Aryan-G4/hornet_kb/README.md

# hornet_kb
Hardware and Firmware for the Hornet Keyboard: a wireless. split. lowprofile hotswap keybaord
