Aryan-G4/hornet_kb/Hardware/hornet_kb.kicad_pcb

## KiCad design Hardware/hornet_kb.kicad_pcb (2025-10-25)

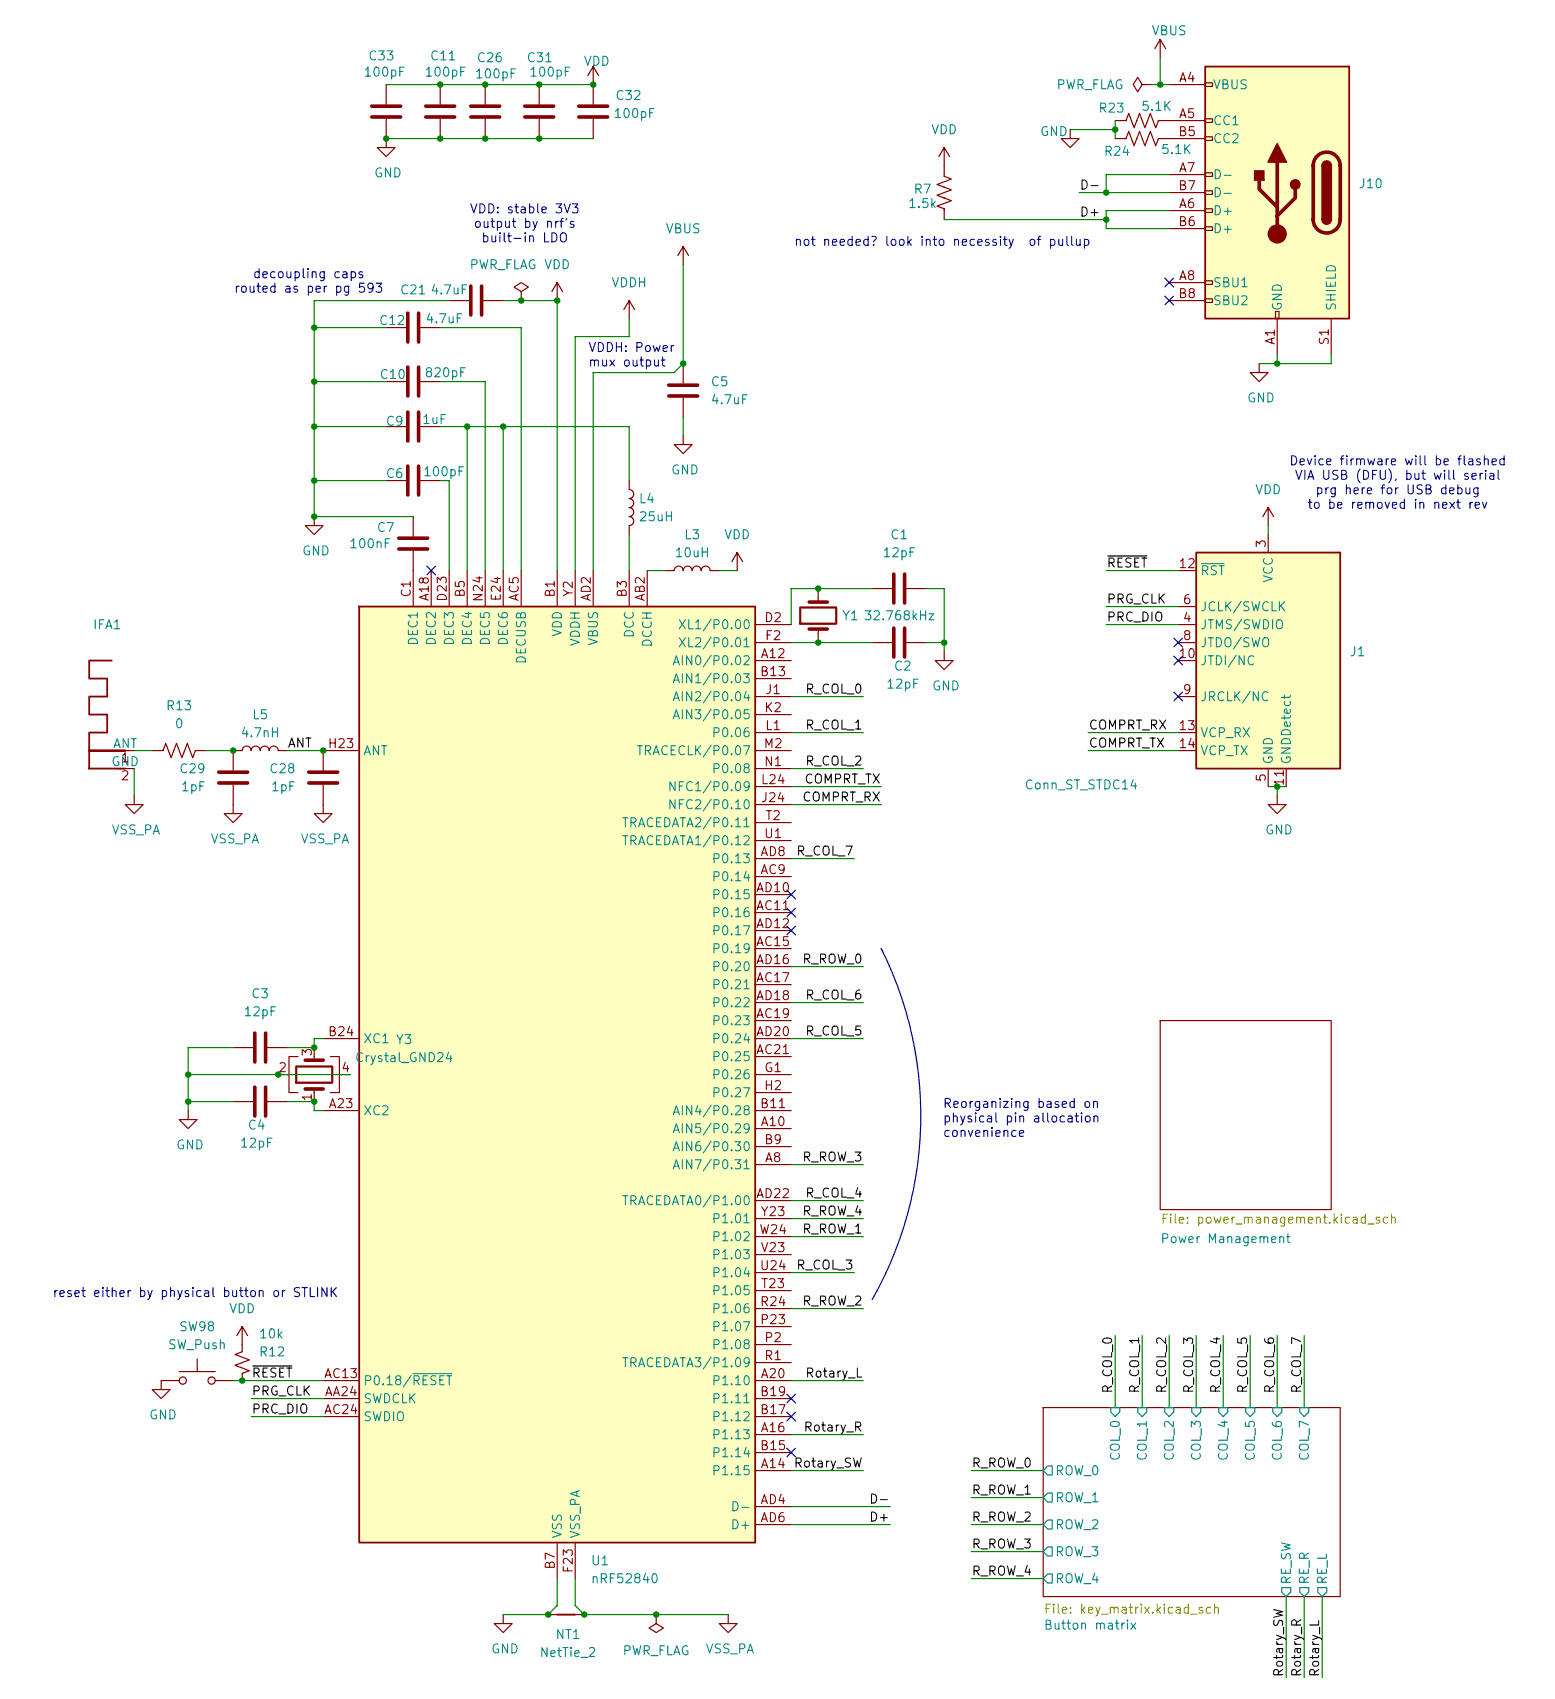
[picture p1: schematic hornet_kb.kicad_sch, Hornet Wireless Split Keyboard]

Parts:
C1, C2, C3, C4: 12pF; C_0402_1005Metric
C5, C12, C21: 4.7uF; C_0805_2012Metric
C6, C11, C26, C31, C32, C33: 100pF; C_0603_1608Metric
C7: 100nF; C_0603_1608Metric
C9: 1uF; C_0603_1608Metric
C10: 820pF; C_0603_1608Metric
C28, C29: 1pF; C_0402_1005Metric
IFA1: Texas_SWRA117D_2.4GHz_Right
J1: Conn_ST_STDC14; Tag-Connect_TC2070-IDC-FP_2x07_P1.27mm_Vertical
J10: USB_C_Receptacle_USB2.0; USB_C_Receptacle_HRO_TYPE-C-31-M-12; LCSC C165948
L3: 10uH; L_0402_1005Metric
L4: 25uH; L_0402_1005Metric
L5: 4.7nH; L_0402_1005Metric
NT1: NetTie_2; NetTie-2_SMD_Pad2.0mm
R7: 1.5k; R_0603_1608Metric; LCSC C23345
R12: 10k; R_0603_1608Metric
R13: 0; R_0402_1005Metric
R23, R24: 5.1K; R_0603_1608Metric; LCSC C23186
SW98: SW_Push; SW_Push_1P1T-MP_NO_Horizontal_Alps_SKRTLAE010
U1: nRF52840; Nordic_AQFN-73-1EP_7x7mm_P0.5mm
Y1: 32.768kHz; Crystal_SMD_3215-2Pin_3.2x1.5mm
Y3: Crystal_GND24; Crystal_SMD_2016-4Pin_2.0x1.6mm

Connections:
/ANT: C28.1, L5.1, U1.H23 (ANT)
/COMPRT_RX: J1.13 (VCP_RX), U1.J24 (NFC2/P0.10)
/COMPRT_TX: J1.14 (VCP_TX), U1.L24 (NFC1/P0.09)
/D+: J10.A6 (D+), J10.B6 (D+), R7.2, U1.AD6 (D+)
/D-: J10.A7 (D-), J10.B7 (D-), U1.AD4 (D-)
/PRC_DIO: J1.4 (JTMS/SWDIO), U1.AC24 (SWDIO)
/PRG_CLK: J1.6 (JCLK/SWCLK), U1.AA24 (SWDCLK)
/R_COL_0: U1.J1 (AIN2/P0.04); also elsewhere on the board
/R_COL_1: U1.L1 (P0.06); also elsewhere on the board
/R_COL_2: U1.N1 (P0.08); also elsewhere on the board
/R_COL_3: U1.U24 (P1.04); also elsewhere on the board
/R_COL_4: U1.AD22 (TRACEDATA0/P1.00); also elsewhere on the board
/R_COL_5: U1.AD20 (P0.24); also elsewhere on the board
/R_COL_6: U1.AD18 (P0.22); also elsewhere on the board
/R_COL_7: U1.AD8 (P0.13); also elsewhere on the board
/R_ROW_0: U1.AD16 (P0.20); also elsewhere on the board
/R_ROW_1: U1.W24 (P1.02); also elsewhere on the board
/R_ROW_2: U1.R24 (P1.06); also elsewhere on the board
/R_ROW_3: U1.A8 (AIN7/P0.31); also elsewhere on the board
/R_ROW_4: U1.Y23 (P1.01); also elsewhere on the board
/Rotary_L: U1.A20 (P1.10); also elsewhere on the board
/Rotary_R: U1.A16 (P1.13); also elsewhere on the board
/Rotary_SW: U1.A14 (P1.15); also elsewhere on the board
/~RESET: J1.12 (~RST), R12.2, SW98.1, U1.AC13 (P0.18/~RESET)
GND: C1.1, C2.1, C3.1, C4.1, C5.2, C6.2, C7.2, C9.2, C10.1, C11.2, C12.2, C21.1, C26.2, C31.2, C32.2, C33.2, J1.5 (GND), J1.7 (GND), J1.11 (GNDDetect), J10.A1 (GND), J10.A12 (GND), J10.B1 (GND), J10.B12 (GND), J10.S1 (SHIELD), NT1.2, R23.1, R24.1, SW98.2, U1.B7 (VSS), U1.EP (VSS), Y3.2, Y3.4; also elsewhere on the board
unnamed: C29.1, L5.2, R13.2
unnamed: IFA1.1 (ANT), R13.1
unnamed: J10.A5 (CC1), R23.2
unnamed: J10.B5 (CC2), R24.2
unnamed: L4.1, U1.B3 (DCC)
unnamed: L3.2, U1.AB2 (DCCH)
unnamed: C7.1, U1.C1 (DEC1)
unnamed: C6.1, U1.D23 (DEC3)
unnamed: C9.1, L4.2, U1.B5 (DEC4), U1.E24 (DEC6)
unnamed: C10.2, U1.N24 (DEC5)
unnamed: C12.1, U1.AC5 (DECUSB)
unnamed: C3.2, U1.B24 (XC1), Y3.3
unnamed: C4.2, U1.A23 (XC2), Y3.1
unnamed: C1.2, U1.D2 (XL1/P0.00), Y1.2
unnamed: C2.2, U1.F2 (XL2/P0.01), Y1.1
VBUS: C5.1, J10.A4 (VBUS), J10.A9 (VBUS), J10.B4 (VBUS), J10.B9 (VBUS), U1.AD2 (VBUS); also elsewhere on the board
VDD: C11.1, C21.2, C26.1, C31.1, C32.1, C33.1, J1.3 (VCC), L3.1, R7.1, R12.1, U1.A22 (VDD), U1.AD14 (VDD), U1.AD23 (VDD), U1.B1 (VDD), U1.W1 (VDD); also elsewhere on the board
VDDH: U1.Y2 (VDDH); also elsewhere on the board
VSS_PA: C28.2, C29.2, IFA1.2 (GND), NT1.1, U1.F23 (VSS_PA)

Notes on the sheet:
Reorganizing based on physical pin allocation convenience
VDDH: Power mux output
Device firmware will be flashed VIA USB (DFU), but will serial prg here for USB debug to be removed in next rev
decoupling caps routed as per pg 593
VDD: stable 3V3 output by nrf's built-in LDO
reset either by physical button or STLINK
not needed? look into necessity of pullup

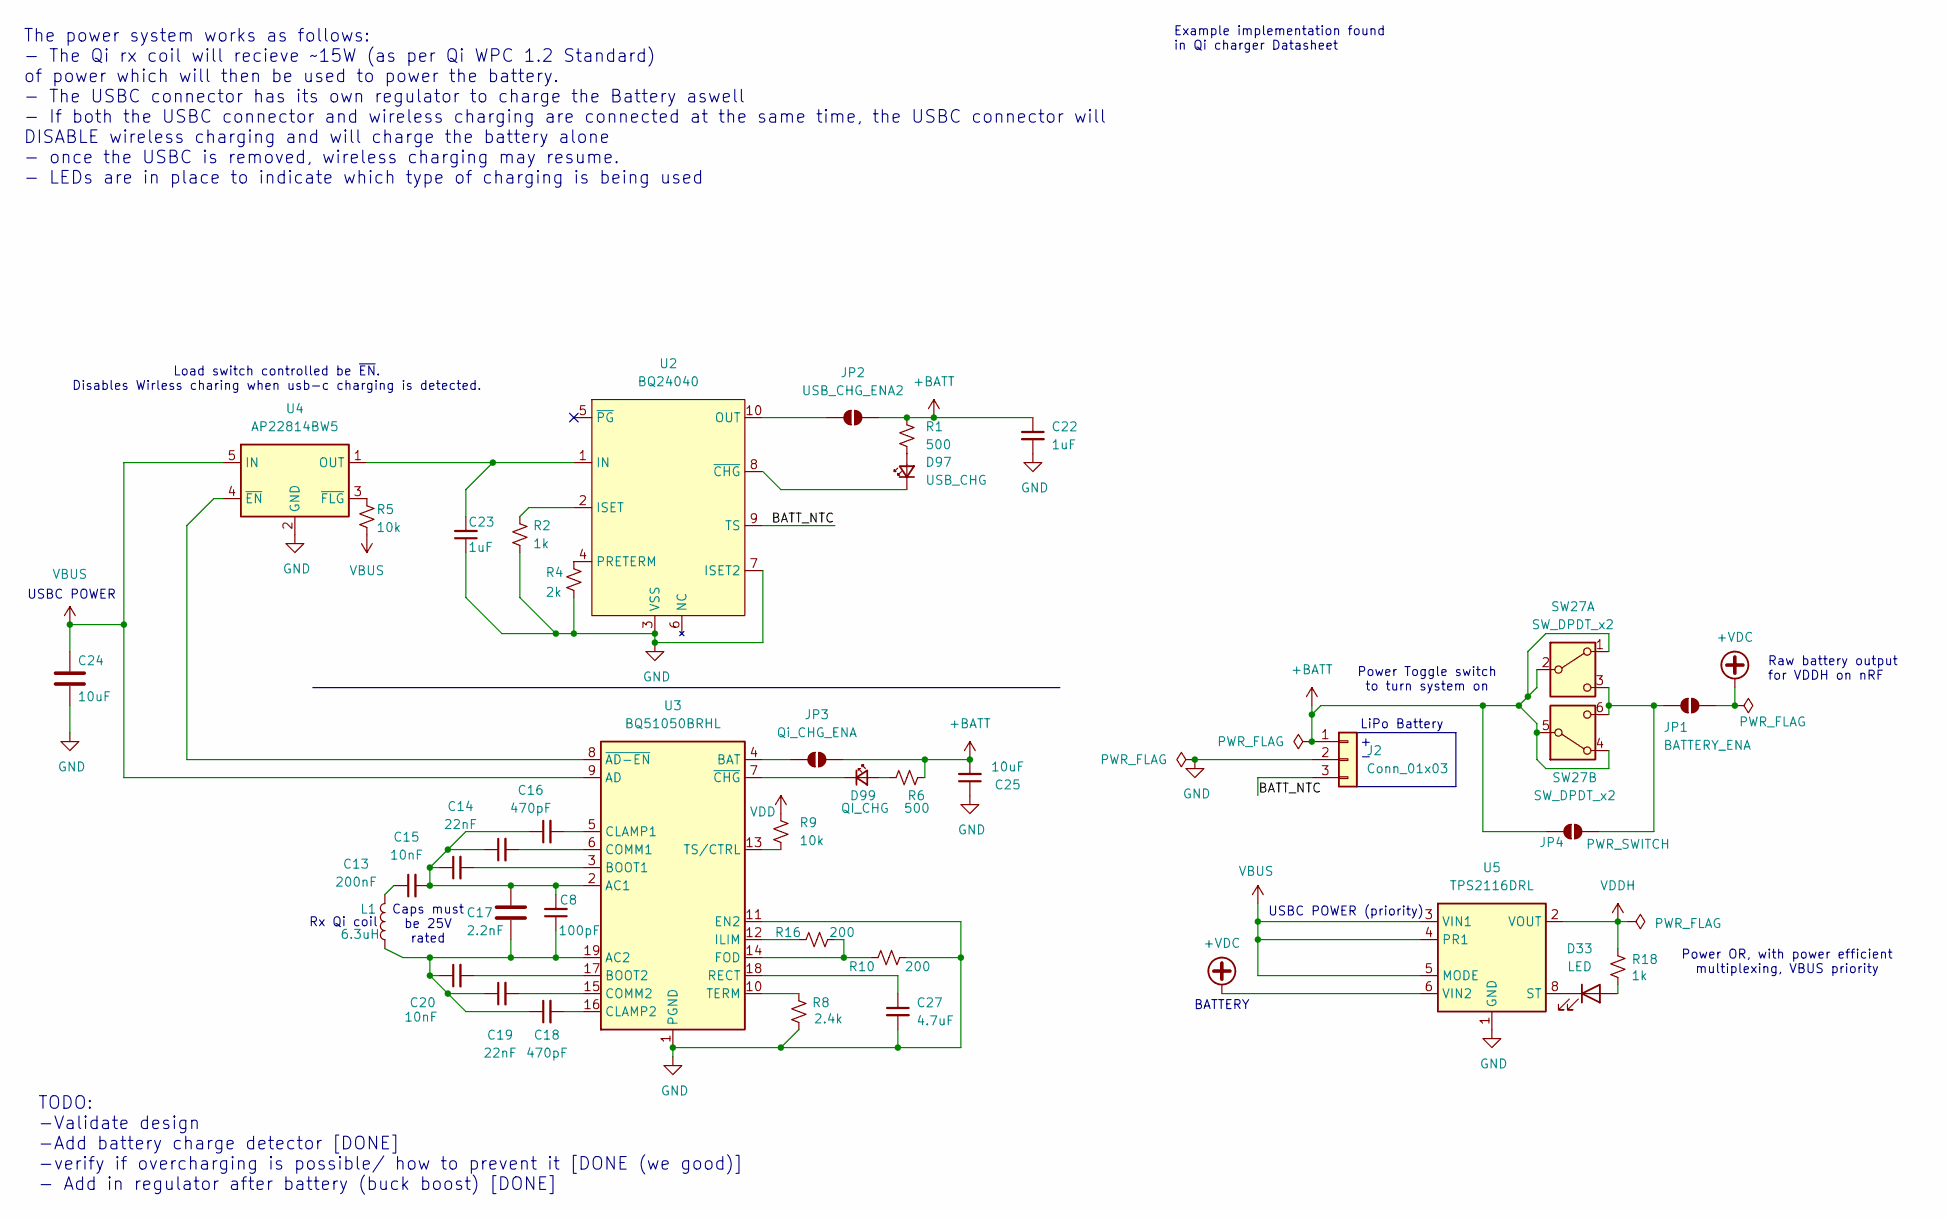
[picture p2: schematic power_management.kicad_sch, Hornet Wireless Split Keyboard]

Parts:
C8: 100pF; C_0603_1608Metric
C13: 200nF; C_0603_1608Metric
C14, C19: 22nF; C_0603_1608Metric
C15, C20: 10nF; C_0603_1608Metric
C16, C18: 470pF; C_0603_1608Metric
C17: 2.2nF; C_0603_1608Metric
C22, C23: 1uF; C_0603_1608Metric
C24, C25: 10uF; C_0603_1608Metric
C27: 4.7uF; C_0603_1608Metric
D33: LED; LED_0402_1005Metric
D97: USB_CHG; LED_0402_1005Metric
D99: QI_CHG; LED_0402_1005Metric
J2: Conn_01x03; JST_GH_SM03B-GHS-TB_1x03-1MP_P1.25mm_Horizontal
JP1: BATTERY_ENA; SolderJumper-2_P1.3mm_Open_TrianglePad1.0x1.5mm
JP2: USB_CHG_ENA2; SolderJumper-2_P1.3mm_Open_TrianglePad1.0x1.5mm
JP3: Qi_CHG_ENA; SolderJumper-2_P1.3mm_Open_TrianglePad1.0x1.5mm
JP4: PWR_SWITCH; SolderJumper-2_P1.3mm_Open_TrianglePad1.0x1.5mm
L1: 6.3uH; JST_EH_S2B-EH_1x02_P2.50mm_Horizontal
R1, R6: 500; R_0603_1608Metric
R2, R18: 1k; R_0603_1608Metric
R4: 2k; R_0603_1608Metric
R5, R9: 10k; R_0603_1608Metric
R8: 2.4k; R_0603_1608Metric
R10, R16: 200; R_0603_1608Metric
SW27: SW_DPDT_x2; SW_CK_JS202011CQN_DPDT_Straight
U2: BQ24040; Texas_DLH0010A_WSON-10-1EP_2.2x2mm_P0.4mm_EP0.9x1.5mm_Therm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
U3: BQ51050BRHL; Texas_VQFN-RHL-20
U4: AP22814BW5; SOT-23-5
U5: TPS2116DRL; SOT-583-8

Connections:
+BATT: C22.1, C25.2, J2.1, JP2.2 (B), JP3.2 (B), JP4.1 (A), R1.1, R6.1, SW27.1 (A), SW27.2 (B), SW27.4 (A), SW27.5 (B)
+VDC: JP1.2 (B), U5.6 (VIN2)
/Power Management/BATT_NTC: J2.3, U2.9 (TS)
GND: C22.2, C23.1, C24.2, C25.1, C27.2, J2.2, R2.1, R4.1, R8.2, R10.2, U2.3 (VSS), U2.7 (ISET2), U3.1 (PGND), U3.11 (EN2), U3.20 (PGND), U3.21 (PGND), U4.2 (GND), U5.1 (GND); also elsewhere on the board
unnamed: C13.1, L1.2
unnamed: D33.2 (A), R18.1
unnamed: D33.1 (K), U5.8 (ST)
unnamed: D97.2 (A), R1.2
unnamed: D97.1 (K), U2.8 (~CHG)
unnamed: D99.2 (A), R6.2
unnamed: D99.1 (K), U3.7 (~CHG)
unnamed: JP1.1 (A), JP4.2 (B), SW27.3 (C), SW27.6 (C)
unnamed: JP2.1 (A), U2.10 (OUT)
unnamed: JP3.1 (A), U3.4 (BAT)
unnamed: C23.2, U2.1 (IN), U4.1 (OUT)
unnamed: R2.2, U2.2 (ISET)
unnamed: R4.2, U2.4 (PRETERM)
unnamed: C8.2, C13.2, C14.1, C15.1, C16.1, C17.1, U3.2 (AC1)
unnamed: C8.1, C17.2, C18.1, C19.1, C20.1, L1.1, U3.19 (AC2)
unnamed: C15.2, U3.3 (BOOT1)
unnamed: C20.2, U3.17 (BOOT2)
unnamed: C16.2, U3.5 (CLAMP1)
unnamed: C18.2, U3.16 (CLAMP2)
unnamed: C14.2, U3.6 (COMM1)
unnamed: C19.2, U3.15 (COMM2)
unnamed: R10.1, R16.2, U3.14 (FOD)
unnamed: R16.1, U3.12 (ILIM)
unnamed: C27.1, U3.18 (RECT)
unnamed: R8.1, U3.10 (TERM)
unnamed: R9.2, U3.13 (TS/CTRL)
unnamed: U3.8 (~AD-EN), U4.4 (~EN)
unnamed: R5.2, U4.3 (~FLG)
VBUS: C24.1, R5.1, U3.9 (AD), U4.5 (IN), U5.3 (VIN1), U5.4 (PR1), U5.5 (MODE); also elsewhere on the board
VDD: R9.1; also elsewhere on the board
VDDH: R18.2, U5.2 (VOUT), U5.7 (VOUT); also elsewhere on the board

Notes on the sheet:
Power OR, with power efficient multiplexing, VBUS priority
Rx Qi coil
The power system works as follows: - The Qi rx coil will recieve ~15W (as per Qi WPC 1.2 Standard) of power which will then be used to power the battery. - The USBC connector has its own regulator to charge the Battery aswell - If both the USBC connector and wireless charging are connected at the s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
Raw battery output for VDDH on nRF
USBC POWER (priority)
USBC POWER
LiPo Battery
Example implementation found in Qi charger Datasheet
BATTERY
Caps must be 25V rated
Load switch controlled be ~{EN}. Disables Wirless charing when usb-c charging is detected.
Power Toggle switch to turn system on
+ -
TODO: -Validate design -Add battery charge detector [DONE] -verify if overcharging is possible/ how to prevent it [DONE (we good)] - Add in regulator after battery (buck boost) [DONE]

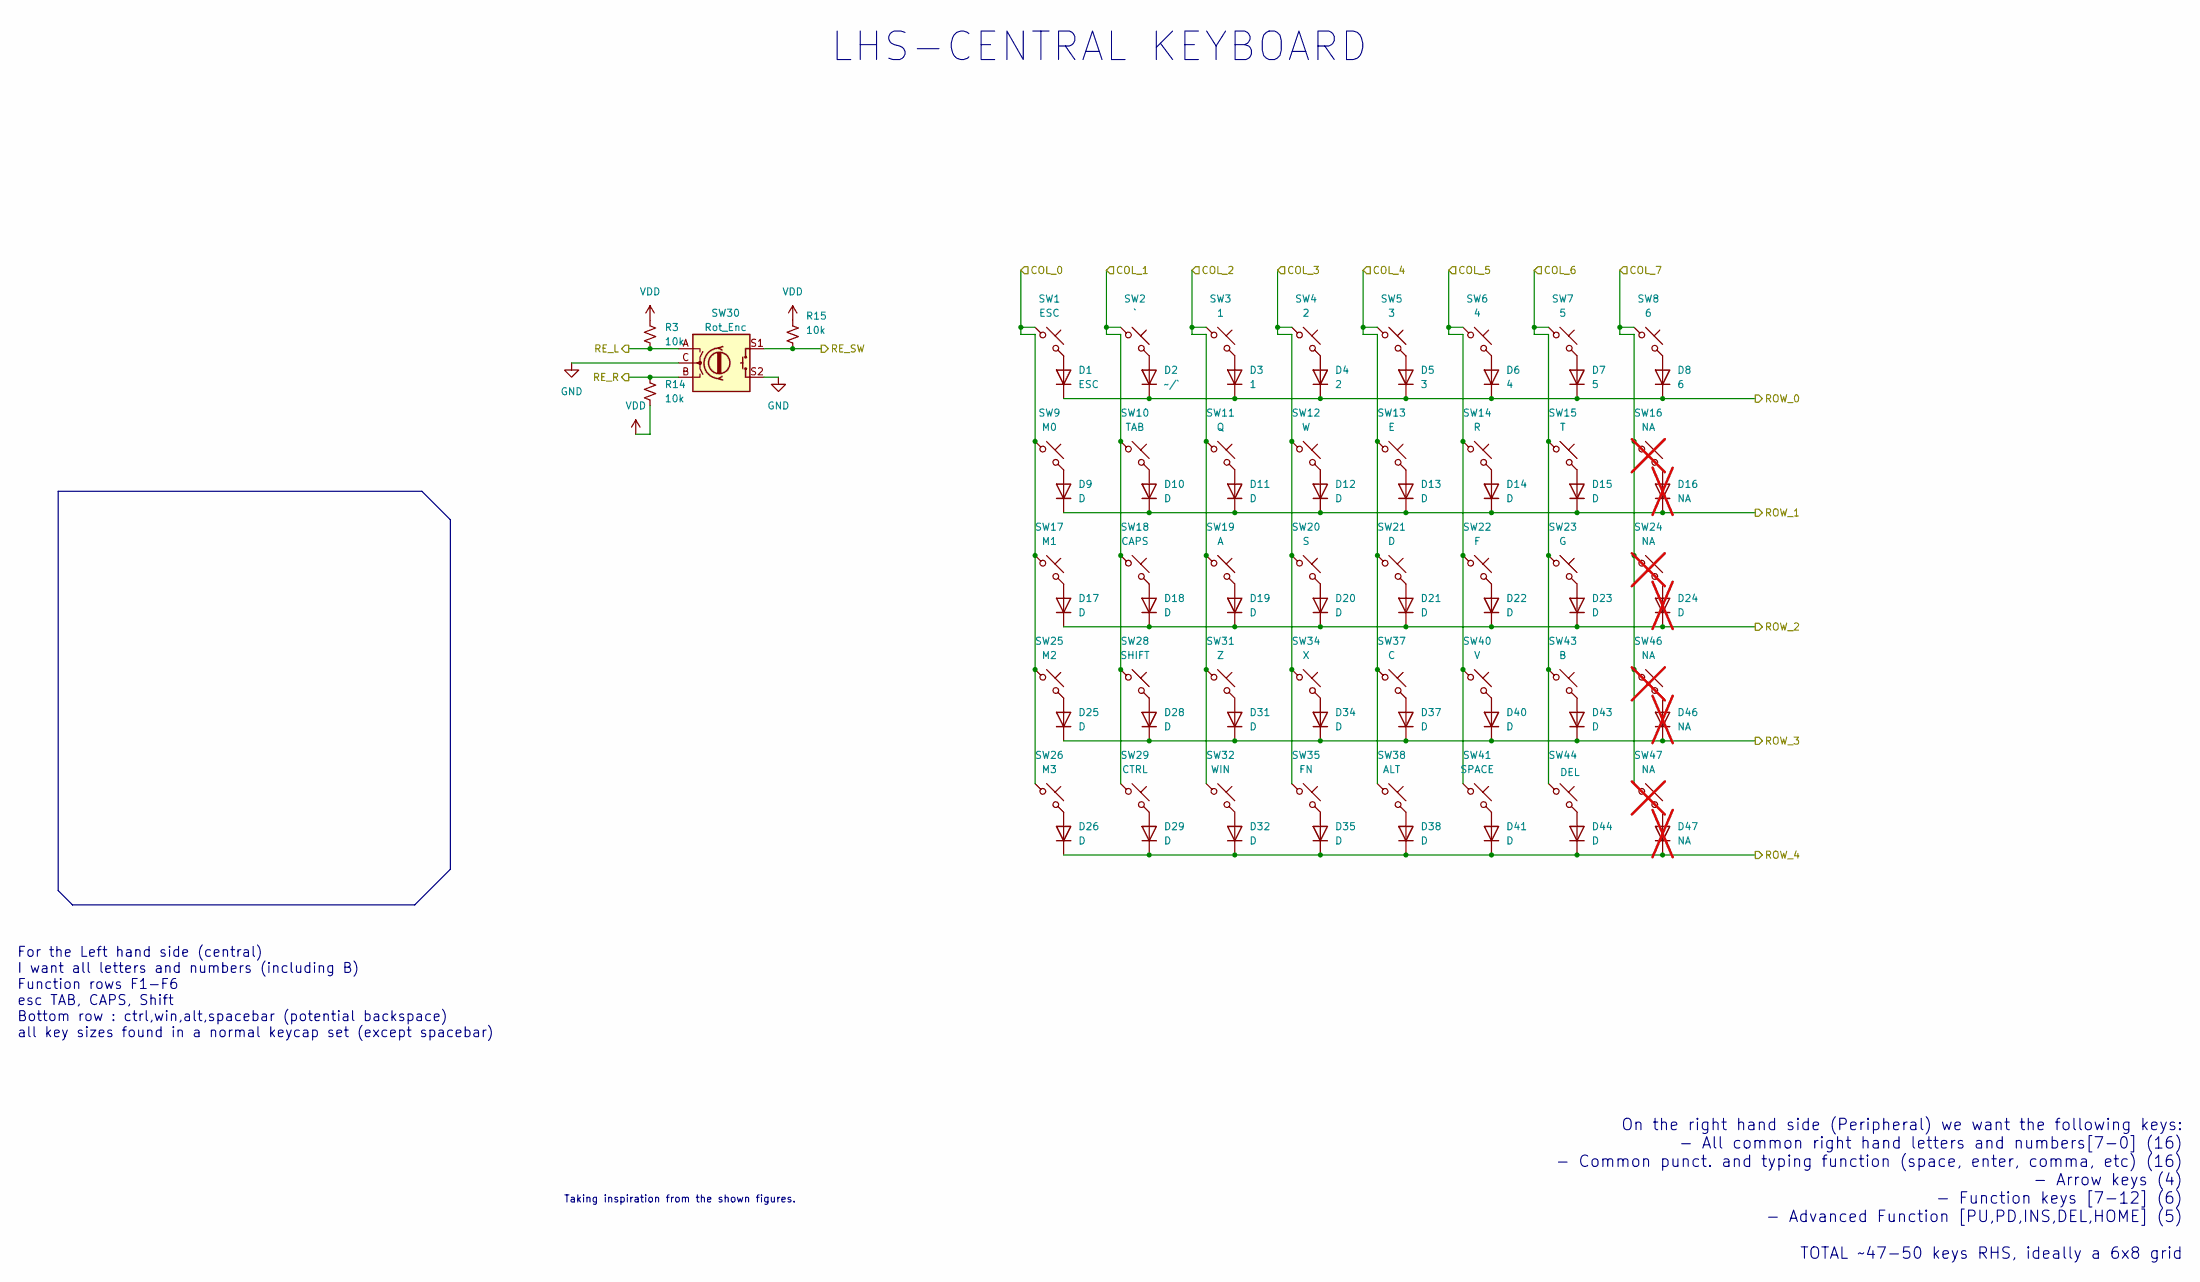
[picture p3: schematic key_matrix.kicad_sch, Hornet Wireless Split Keyboard]

Parts:
D1: ESC; Diode_SOD-123
D2: ~/`; Diode_SOD-123
D3: 1; Diode_SOD-123
D4: 2; Diode_SOD-123
D5: 3; Diode_SOD-123
D6: 4; Diode_SOD-123
D7: 5; Diode_SOD-123
D8: 6; Diode_SOD-123
D9, D10, D11, D12, D13, D14, D15, D17, D18, D19, D20, D21, D22, D23, D25, D26, D28, D29, D31, D32, D34, D35, D37, D38, D40, D41, D43, D44: D; Diode_SOD-123
D16, D46, D47: NA; Diode_SOD-123; not fitted
D24: D; Diode_SOD-123; not fitted
R3, R14, R15: 10k; R_0603_1608Metric
SW1: ESC; Hotswap_MX_1.00u
SW2: `; Hotswap_MX_1.00u
SW3: 1; Hotswap_MX_1.00u
SW4: 2; Hotswap_MX_1.00u
SW5: 3; Hotswap_MX_1.00u
SW6: 4; Hotswap_MX_1.00u
SW7: 5; Hotswap_MX_1.00u
SW8: 6; Hotswap_MX_1.00u
SW9: M0; Hotswap_MX_1.00u
SW10: TAB; Hotswap_MX_1.50u
SW11: Q; Hotswap_MX_1.00u
SW12: W; Hotswap_MX_1.00u
SW13: E; Hotswap_MX_1.00u
SW14: R; Hotswap_MX_1.00u
SW15: T; Hotswap_MX_1.00u
SW16: NA; Hotswap_MX_1.00u; not fitted
SW17: M1; Hotswap_MX_1.00u
SW18: CAPS; Hotswap_MX_1.75u
SW19: A; Hotswap_MX_1.00u
SW20: S; Hotswap_MX_1.00u
SW21: D; Hotswap_MX_1.00u
SW22: F; Hotswap_MX_1.00u
SW23: G; Hotswap_MX_1.00u
SW24: NA; Hotswap_MX_1.50u; not fitted
SW25: M2; Hotswap_MX_1.00u
SW26: M3; Hotswap_MX_1.00u
SW28: SHIFT; Hotswap_MX_2.25u
SW29: CTRL; Hotswap_MX_1.25u
SW30: Rot_Enc; RotaryEncoder_Alps_EC11E-Switch_Vertical_H20mm
SW31: Z; Hotswap_MX_1.00u
SW32: WIN; Hotswap_MX_1.00u
SW34: X; Hotswap_MX_1.00u
SW35: FN; Hotswap_MX_1.25u
SW37: C; Hotswap_MX_1.00u
SW38: ALT; Hotswap_MX_1.25u
SW40: V; Hotswap_MX_1.00u
SW41: SPACE; Hotswap_MX_2.25u
SW43: B; Hotswap_MX_1.00u
SW44: DEL; Hotswap_MX_1.00u
SW46, SW47: NA; not fitted

Connections:
/R_COL_0: SW1.1, SW9.1, SW17.1, SW25.1, SW26.1; also elsewhere on the board
/R_COL_1: SW2.1, SW10.1, SW18.1, SW28.1, SW29.1; also elsewhere on the board
/R_COL_2: SW3.1, SW11.1, SW19.1, SW31.1, SW32.1; also elsewhere on the board
/R_COL_3: SW4.1, SW12.1, SW20.1, SW34.1, SW35.1; also elsewhere on the board
/R_COL_4: SW5.1, SW13.1, SW21.1, SW37.1, SW38.1; also elsewhere on the board
/R_COL_5: SW6.1, SW14.1, SW22.1, SW40.1, SW41.1; also elsewhere on the board
/R_COL_6: SW7.1, SW15.1, SW23.1, SW43.1, SW44.1; also elsewhere on the board
/R_COL_7: SW8.1, SW16.1, SW24.1, SW46.1, SW47.1; also elsewhere on the board
/R_ROW_0: D1.1 (K), D2.1 (K), D3.1 (K), D4.1 (K), D5.1 (K), D6.1 (K), D7.1 (K), D8.1 (K); also elsewhere on the board
/R_ROW_1: D9.1 (K), D10.1 (K), D11.1 (K), D12.1 (K), D13.1 (K), D14.1 (K), D15.1 (K), D16.1 (K); also elsewhere on the board
/R_ROW_2: D17.1 (K), D18.1 (K), D19.1 (K), D20.1 (K), D21.1 (K), D22.1 (K), D23.1 (K), D24.1 (K); also elsewhere on the board
/R_ROW_3: D25.1 (K), D28.1 (K), D31.1 (K), D34.1 (K), D37.1 (K), D40.1 (K), D43.1 (K), D46.1 (K); also elsewhere on the board
/R_ROW_4: D26.1 (K), D29.1 (K), D32.1 (K), D35.1 (K), D38.1 (K), D41.1 (K), D44.1 (K), D47.1 (K); also elsewhere on the board
/Rotary_L: R3.1, SW30.A; also elsewhere on the board
/Rotary_R: R14.2, SW30.B; also elsewhere on the board
/Rotary_SW: R15.1, SW30.S1; also elsewhere on the board
GND: SW30.C, SW30.S2; also elsewhere on the board
unnamed: D1.2 (A), SW1.2
unnamed: D2.2 (A), SW2.2
unnamed: D3.2 (A), SW3.2
unnamed: D4.2 (A), SW4.2
unnamed: D5.2 (A), SW5.2
unnamed: D6.2 (A), SW6.2
unnamed: D7.2 (A), SW7.2
unnamed: D8.2 (A), SW8.2
unnamed: D9.2 (A), SW9.2
unnamed: D10.2 (A), SW10.2
unnamed: D11.2 (A), SW11.2
unnamed: D12.2 (A), SW12.2
unnamed: D13.2 (A), SW13.2
unnamed: D14.2 (A), SW14.2
unnamed: D15.2 (A), SW15.2
unnamed: D16.2 (A), SW16.2
unnamed: D17.2 (A), SW17.2
unnamed: D18.2 (A), SW18.2
unnamed: D19.2 (A), SW19.2
unnamed: D20.2 (A), SW20.2
unnamed: D21.2 (A), SW21.2
unnamed: D22.2 (A), SW22.2
unnamed: D23.2 (A), SW23.2
unnamed: D24.2 (A), SW24.2
unnamed: D25.2 (A), SW25.2
unnamed: D26.2 (A), SW26.2
unnamed: D28.2 (A), SW28.2
unnamed: D29.2 (A), SW29.2
unnamed: D31.2 (A), SW31.2
unnamed: D32.2 (A), SW32.2
unnamed: D34.2 (A), SW34.2
unnamed: D35.2 (A), SW35.2
unnamed: D37.2 (A), SW37.2
unnamed: D38.2 (A), SW38.2
unnamed: D40.2 (A), SW40.2
unnamed: D41.2 (A), SW41.2
unnamed: D43.2 (A), SW43.2
unnamed: D44.2 (A), SW44.2
unnamed: D46.2 (A), SW46.2
unnamed: D47.2 (A), SW47.2
VDD: R3.2, R14.1, R15.2; also elsewhere on the board

Notes on the sheet:
For the Left hand side (central) I want all letters and numbers (including B) Function rows F1-F6 esc TAB, CAPS, Shift Bottom row : ctrl,win,alt,spacebar (potential backspace) all key sizes found in a normal keycap set (except spacebar)
On the right hand side (Peripheral) we want the following keys: - All common right hand letters and numbers[7-0] (16) - Common punct. and typing function (space, enter, comma, etc) (16) - Arrow keys (4) - Function keys [7-12] (6) - Advanced Function [PU,PD,INS,DEL,HOME] (5) TOTAL ~47-50 keys RHS, i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
LHS-CENTRAL KEYBOARD
Taking inspiration from the shown figures.

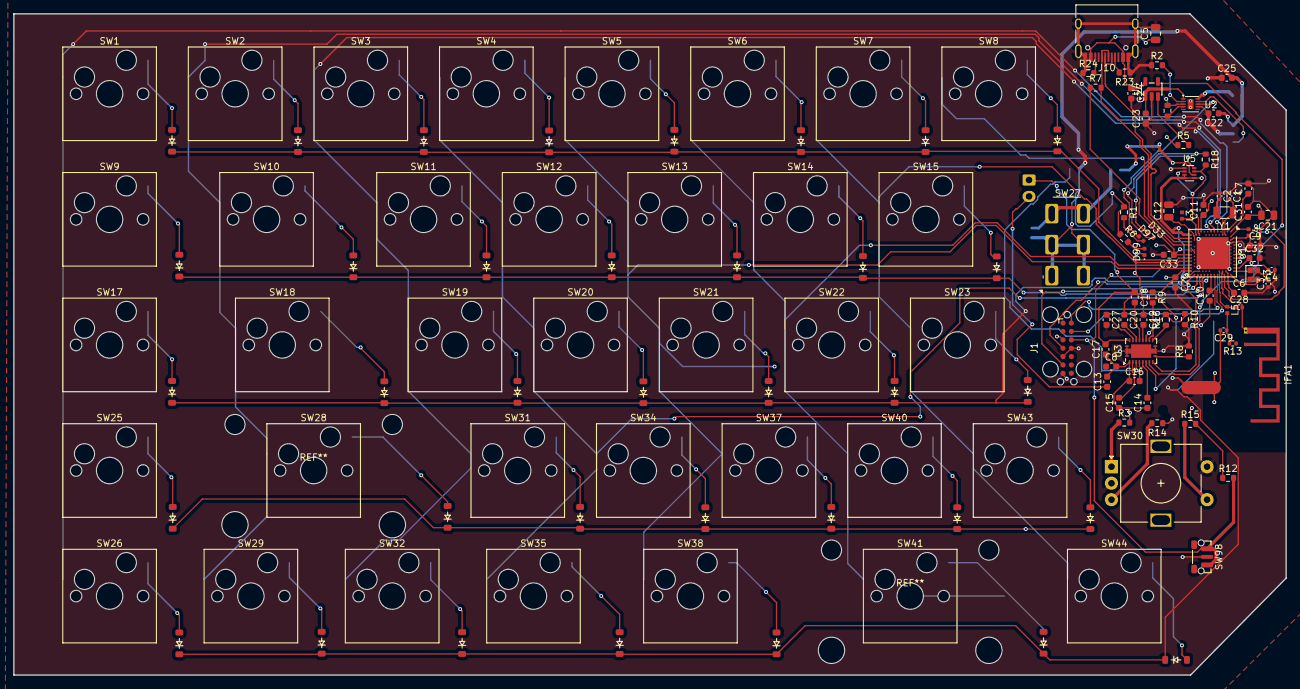
[picture p4: board hornet_kb.kicad_pcb from above]

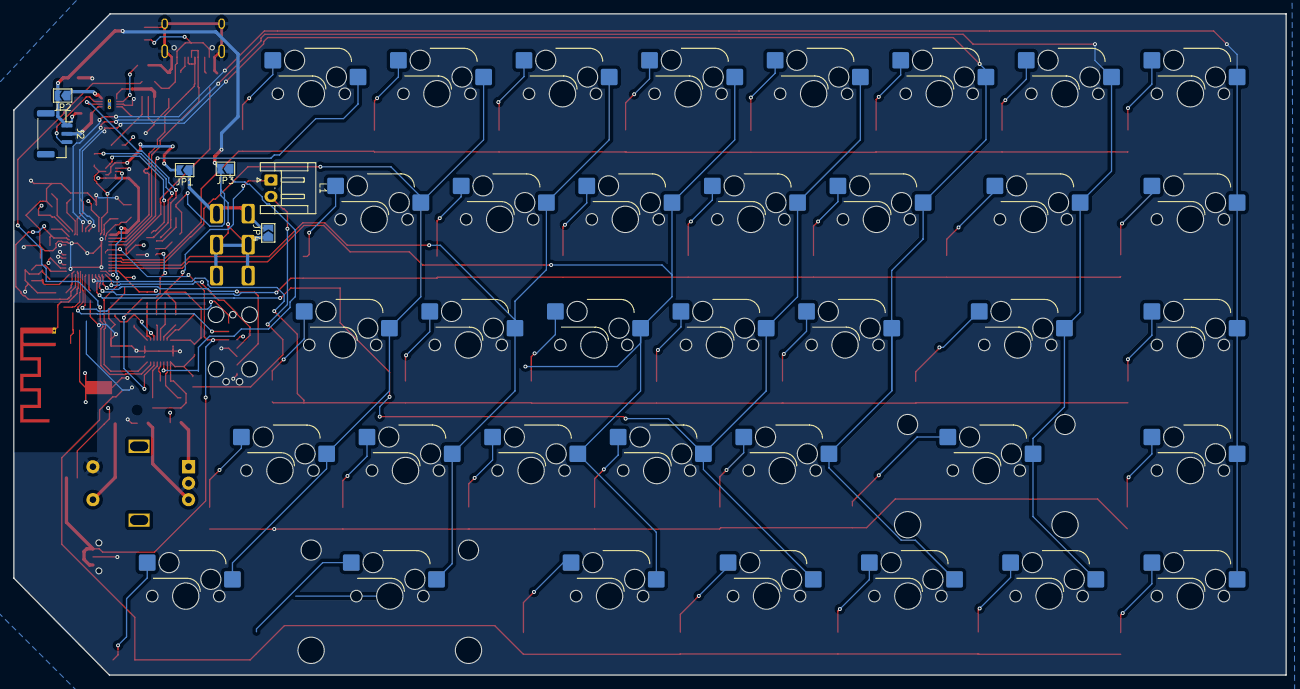
[picture p5: board hornet_kb.kicad_pcb from below]

Board: 4 copper layers, 193.0 x 100.3 mm, 148 parts (6 on the bottom side), 111 nets.
