Aryan-G4/hornet_kb/(commit log)

2025-09-19 Created Kicad project
    [hornet_kb.kicad_pcb, hornet_kb.kicad_sch]
2025-10-05 added new sheet for wireless comms
    [hornet_kb_wireless.kicad_sch]
2025-10-05 Put in mcu and pwoer sheet
    [hornet_kb.kicad_sch, power_management.kicad_sch]
2025-10-05 Added programmer and usbc
    [hornet_kb.kicad_sch, key_matrix.kicad_sch]
2025-10-08 added in HS and LSref crystals
    [hornet_kb.kicad_sch]
2025-10-09 Added external kicad library for niche ass footprints
    [hornet_kb.kicad_sch]
2025-10-10 Complete draft of key matrix for both sides
    [hornet_kb.kicad_sch]
2025-10-10 Added decoupling caps
    [hornet_kb.kicad_pcb, hornet_kb.kicad_sch]
2025-10-10 Draft and spec out power components
    [hornet_kb.kicad_sch, power_management.kicad_sch]
2025-10-11 Add design notes to key_matrix schematic
    Inserted a text block in key_matrix.kicad_sch detailing desired key layout and requirements for the left hand side of the keyboard.
    [key_matrix.kicad_sch]
2025-10-11 added sheet for wireless connectivity
    [hornet_kb_wireless.kicad_sch]
2025-10-11 added sym for inverted f antenna
2025-10-11 added zander layout
    [hornet_kb.kicad_pcb, power_management.kicad_sch]
2025-10-11 Moved BLE implementation into higherarchical page
    [hornet_kb.kicad_sch, wireless_BLE.kicad_sch]
2025-10-11 wired USB battery charger
    [hornet_kb.kicad_sch, power_management.kicad_sch, wireless_BLE.kicad_sch]
2025-10-12 added footprint for IFA
2025-10-12 finish draft of power schematic
    [key_matrix.kicad_sch, power_management.kicad_sch, wireless_BLE.kicad_sch]
2025-10-12 updated gitignore
    [hornet_kb.kicad_sch]
2025-10-14 Complete first ROUGH draft of schematic
    [hornet_kb.kicad_sch, key_matrix.kicad_sch, power_management.kicad_sch, wireless_BLE.kicad_sch]
2025-10-15 Added new keyboard layouts
    [hornet_kb.kicad_sch]
2025-10-16 add datasheet to usb charger and fix erc
    [hornet_kb.kicad_sch, power_management.kicad_sch]
2025-10-16 renamed layout to left hand central
    [key_matrix.kicad_sch]
2025-10-17 Added rev4 of keyboard layout and organized all prev versions into a respective directory
    [power_management.kicad_sch]
2025-10-17 Named all LHS keys
    [key_matrix.kicad_sch]
2025-10-17 Completed Final GUI Key Layout and PCB key layout draft
    [hornet_kb.kicad_pcb, key_matrix.kicad_sch, power_management.kicad_sch]
2025-10-17 added stabilizers to layout
    [hornet_kb.kicad_pcb]
2025-10-17 Marked stabilizers as not in sch
    [hornet_kb.kicad_pcb]
2025-10-17 fix "T" key footprint
    [key_matrix.kicad_sch]
2025-10-18 Update footprints and switch symbol in schematic
    Set proper SMD footprints for capacitors, resistors, inductors, crystals, and net ties in hornet_kb.kicad_sch. In power_management.kicad_sch, replace DIP switch symbol with DPDT switch, update related symbol properties, add new switch instance, and adjust wiring and annotation for improved clarity and functionality. Man i love summarize with copilot
    [hornet_kb.kicad_sch, power_management.kicad_sch]
2025-10-18 Completed keymatrix layout
    [hornet_kb.kicad_pcb, hornet_kb.kicad_sch]
2025-10-19 Added LDO to battery and added placement for the charging modules
    [hornet_kb.kicad_pcb, hornet_kb.kicad_sch, power_management.kicad_sch]
2025-10-19 Change labels from global to netlist
    [hornet_kb.kicad_sch, key_matrix.kicad_sch, power_management.kicad_sch]
2025-10-19 Refactor keyboard and power schematics, remove backups
    Deleted old hornet_kb schematic backup ZIPs. Updated hornet_kb.kicad_sch: reorganized right-hand row/column labels and wires for physical pin convenience, added annotation, and removed redundant global labels. In power_management.kicad_sch: removed decorative Rx coil circles, updated annotation positions and text, and shifted many schematic elements for improved clarity and layout.
    [hornet_kb.kicad_sch, power_management.kicad_sch]
2025-10-19 Update schematic coordinates and add notes
    Adjusted coordinates for wires, junctions, and no_connects in hornet_kb.kicad_sch for improved layout clarity. Added company info and new design notes. Deleted outdated backup ZIP file.
    [hornet_kb.kicad_sch, key_matrix.kicad_sch, power_management.kicad_sch]
2025-10-19 Add higherarchical pins to key matrix
    [hornet_kb.kicad_sch, key_matrix.kicad_sch]
2025-10-19 added rotary encoder to schematic
    [hornet_kb.kicad_sch, key_matrix.kicad_sch]
2025-10-19 added rotary enc higherarchical pins to mcu
    [hornet_kb.kicad_sch]
2025-10-19 Update schematic for rotary encoder and matrix layout
    Added new symbols and labels for rotary encoder connections, updated wire routing and junctions, and adjusted matrix row/column positions for improved clarity and alignment. Also corrected text annotations to better describe left and right hand keyboard sections.
    [hornet_kb.kicad_sch, key_matrix.kicad_sch, power_management.kicad_sch]
2025-10-19 Add antenna symbol and update schematic connections
    Introduced a new Device:Antenna symbol to the hornet_kb schematic and added its instance. Updated various wire and junction connections, including changes to VBUS, GND, and capacitor placements. Replaced GND1 symbols with GND in power_management schematic for consistency. Adjusted text annotations and wire routing in all affected schematics to reflect new connections and improve clarity.
    [hornet_kb.kicad_sch, key_matrix.kicad_sch, power_management.kicad_sch]
2025-10-19 Removed LDO (already one built into nrf)
    [hornet_kb.kicad_sch, key_matrix.kicad_sch, power_management.kicad_sch]
2025-10-19 Update schematic for hornet_kb with new coordinates
    Adjusted coordinates for arcs, text, junctions, no_connects, and wires in hornet_kb.kicad_sch to reflect a new layout or grid. This includes moving various elements to new positions, removing and adding connections, and updating wire paths for improved schematic organization and clarity.
    [hornet_kb.kicad_sch, power_management.kicad_sch]
2025-10-19 Update schematic files and add image to hornet_kb
    Adjusted text position in hornet_kb.kicad_sch, added a large embedded image, and updated key_matrix and power_management schematic files. These changes may improve documentation and visual references within the hardware schematics.
    [hornet_kb.kicad_sch, key_matrix.kicad_sch, power_management.kicad_sch]
2025-10-20 Update power management wiring and resistor positions
    Added a PWR_FLAG symbol to hornet_kb schematic. Modified power_management schematic wiring, removed and added junctions, and adjusted wire connections for improved power routing. Relocated resistors R10 and R16 to new positions to reflect updated circuit layout.
    [hornet_kb.kicad_sch, power_management.kicad_sch]
2025-10-20 Update PCB net names
    [hornet_kb.kicad_pcb, power_management.kicad_sch]
2025-10-20 Changed C22 cap value
    [power_management.kicad_sch]
2025-10-20 assign footprints (rough draft)
    [hornet_kb.kicad_sch, key_matrix.kicad_sch, power_management.kicad_sch]
2025-10-22 Route dual sided hotswap/diodes assmebly
    [hornet_kb.kicad_pcb, hornet_kb.kicad_sch, power_management.kicad_sch]
2025-10-22 added extra decoupling caps to the mcu VDD pins
    [hornet_kb.kicad_pcb, hornet_kb.kicad_sch, power_management.kicad_sch]
2025-10-22 changed pin allocations for keys based on physical location
    [hornet_kb.kicad_pcb]
2025-10-22 move MCU to prioritize BLE routing
    [hornet_kb.kicad_pcb, hornet_kb.kicad_sch]
2025-10-23 added in pwoer mux
    [hornet_kb.kicad_sch, power_management.kicad_sch]
2025-10-23 modified layout placement
    [hornet_kb.kicad_pcb, hornet_kb.kicad_sch, power_management.kicad_sch]
2025-10-24 Fix ERC and stylistic errors
    [hornet_kb.kicad_sch, key_matrix.kicad_sch, power_management.kicad_sch]
2025-10-24 Add Antenna Library to repo
    [hornet_kb.kicad_sch, power_management.kicad_sch]
2025-10-24 Finished draft placement of parts
    [hornet_kb.kicad_pcb, hornet_kb.kicad_sch]
2025-10-24 Update footprints and positions for multiple components
    Changed footprints, positions, and orientations for several components including LEDs, capacitors, net ties, ICs, and antenna in hornet_kb.kicad_pcb. These updates improve layout accuracy and reflect changes in component selection and placement for better manufacturability and electrical performance.
    [hornet_kb.kicad_pcb]
2025-10-24 Completed mcu routing
    [hornet_kb.kicad_pcb, hornet_kb.kicad_sch, power_management.kicad_sch]
2025-10-25 Added jumper to override power switch
    [hornet_kb.kicad_sch, power_management.kicad_sch]
2025-10-25 FINISHED FIRST DRAFT OF LAYOUT!!
    [hornet_kb.kicad_pcb, hornet_kb.kicad_sch]
